Tip-zz/CurrentMeter/Current Meter Schem.png

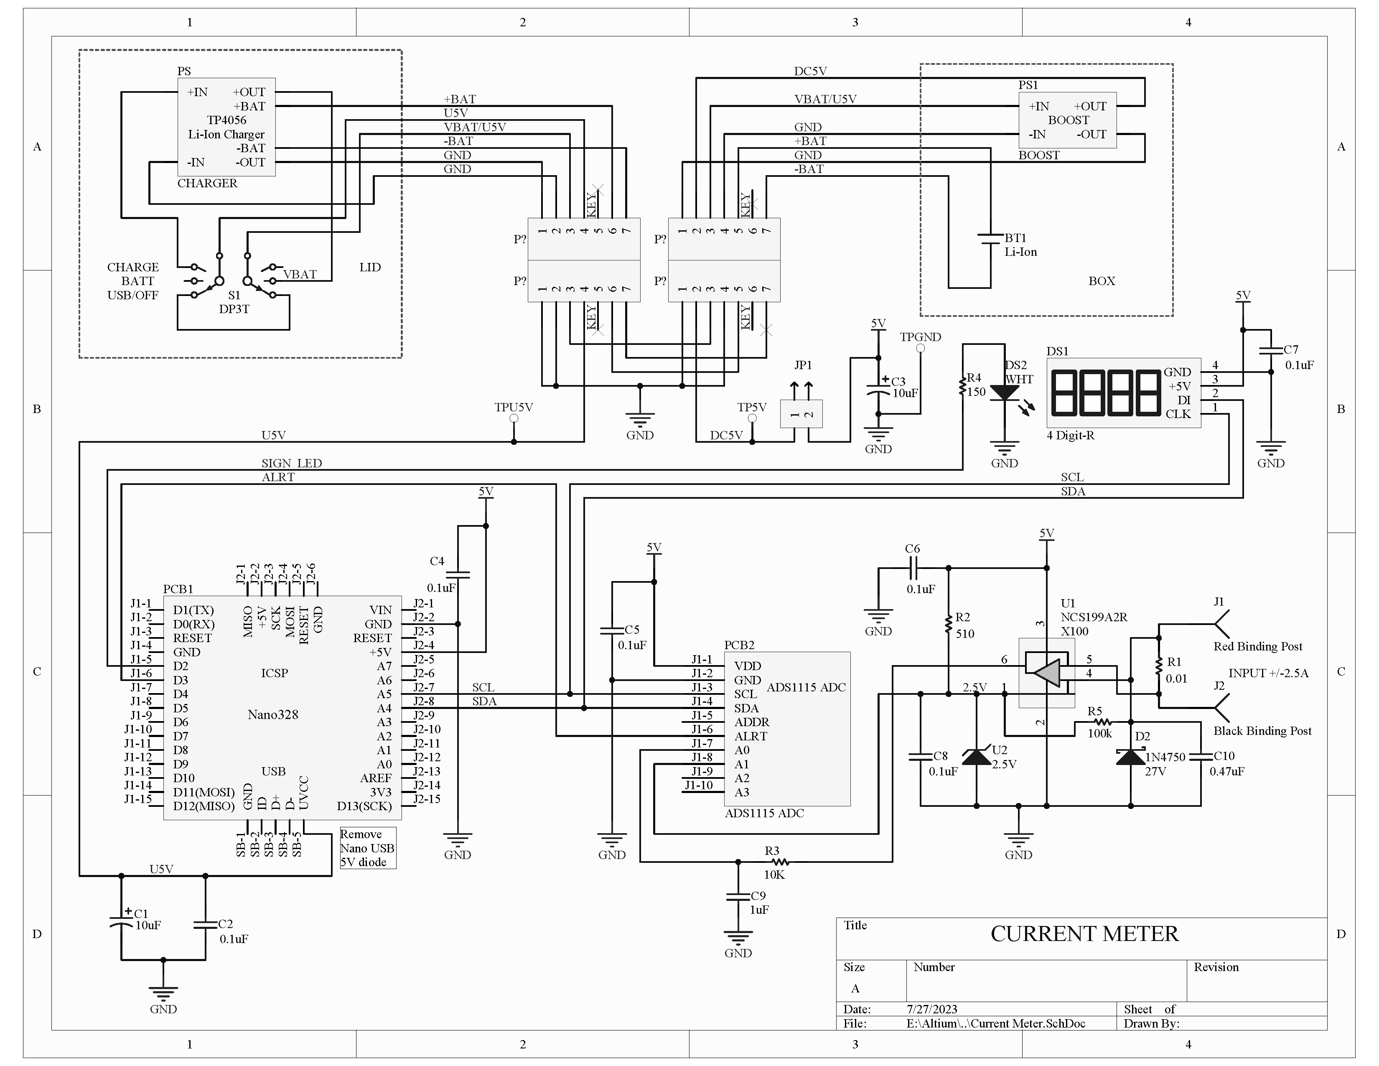
Current Meter Schem.png
