Tip-zz/CurrentMeter/Current Meter Schem.pdf

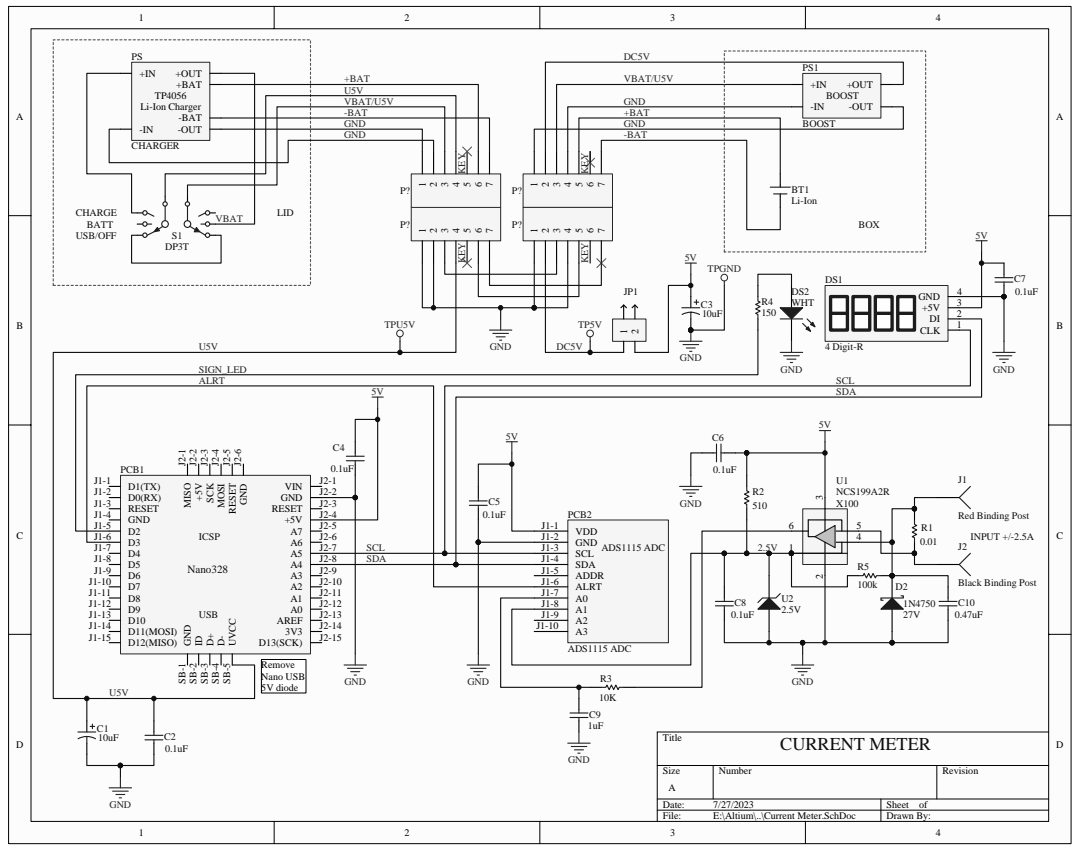
[picture p3: page 1]

Size A | Number | Revision

Date: 7/27/2023 | Sheet of
File: E:\Altium\..\Current Meter.SchDoc | Drawn By:
