Tip-zz/CurrentMeter/(commit log)

2023-07-30 Add files via upload
    CurrentMeter source files. Main file is CurrentMeter.ino
2023-07-30 Add files via upload
    Documentation or project CurrentMeter
2023-07-30 Add files via upload
    Project Electrical schematic
2025-04-30 Add files via upload
    Here is a .png for the schematic since git doesn't seem to display the .pdf.
